matteob29/EA113_-_Conception_dun_amplificateur_audio/PCB/vue_dessous.jpg

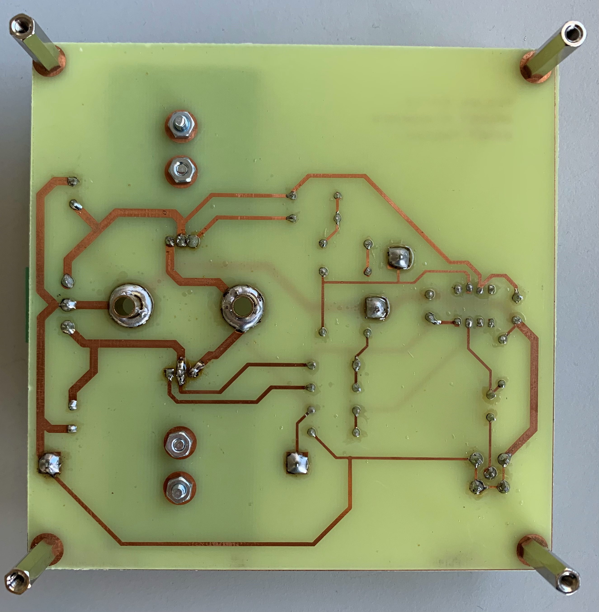
PCB/vue_dessous.jpg
