matteob29/EA113_-_Conception_dun_amplificateur_audio/PCB/vue_cote.jpg

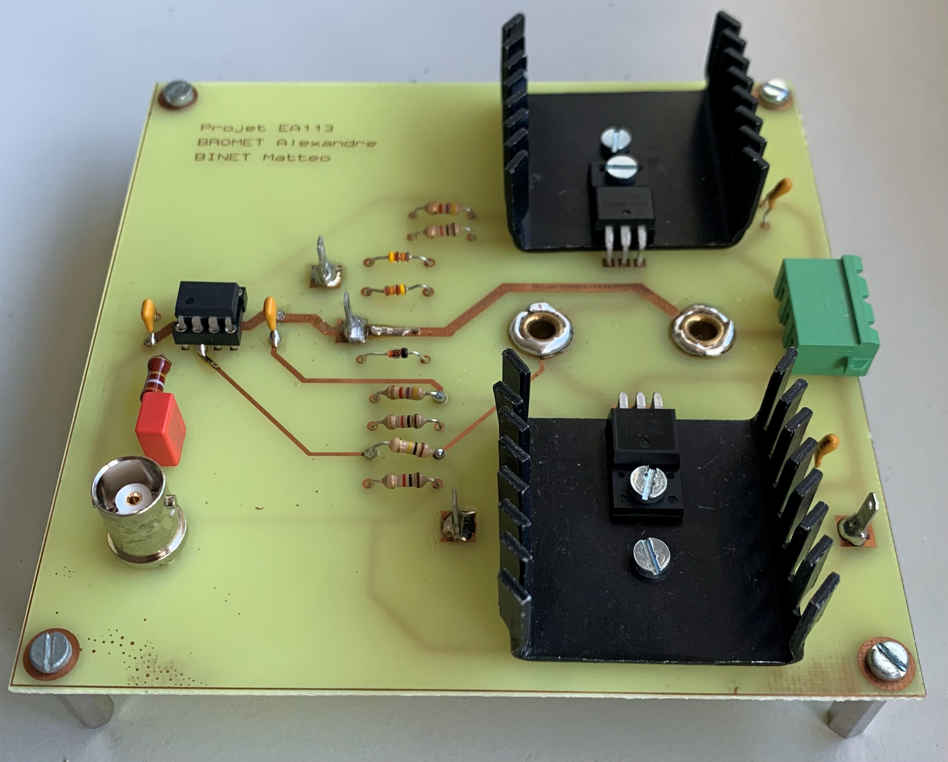
PCB/vue_cote.jpg
