matteob29/EA113_-_Conception_dun_amplificateur_audio/PCB/vue_3D_cote.pdf

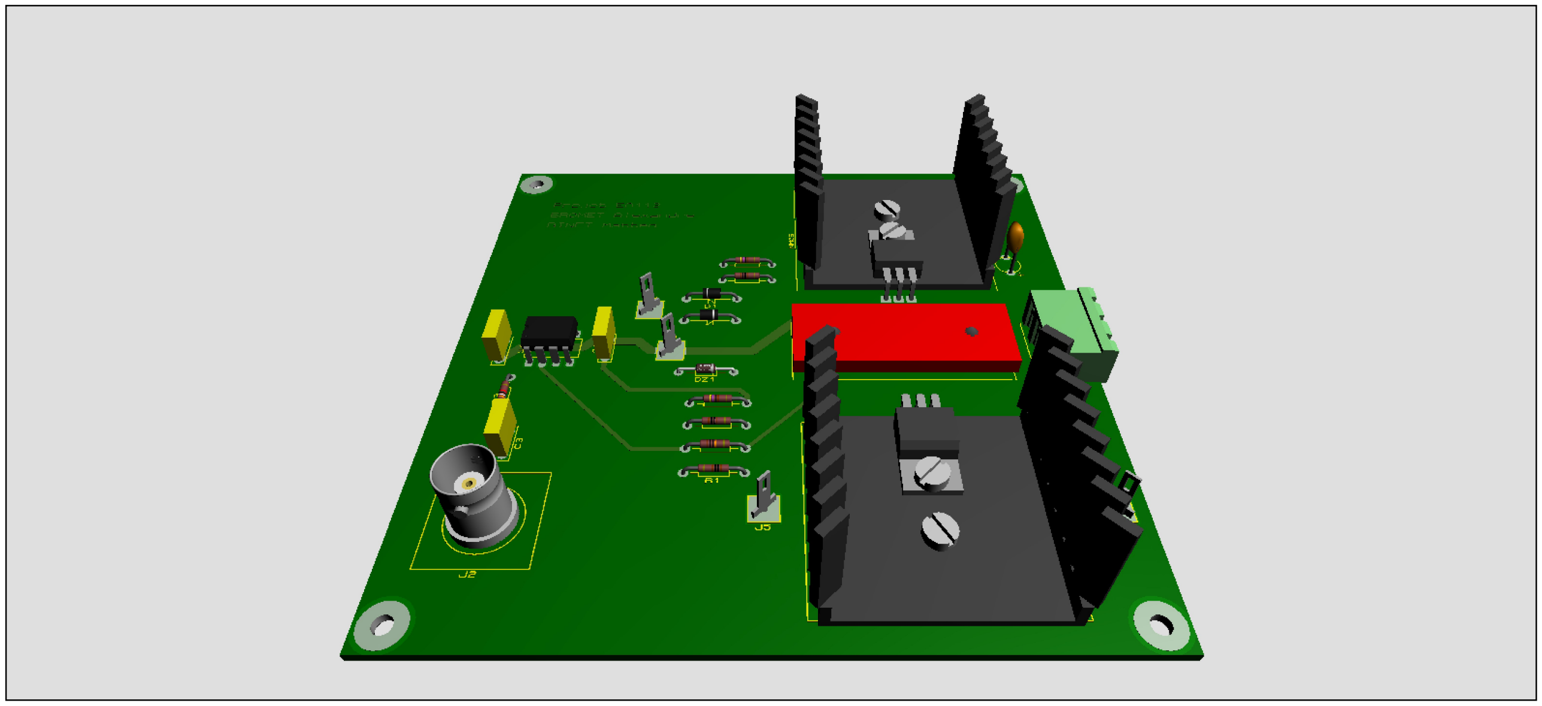
[picture p3: figure]
