matteob29/EA113_-_Conception_dun_amplificateur_audio/PCB/vue_dessus.jpg

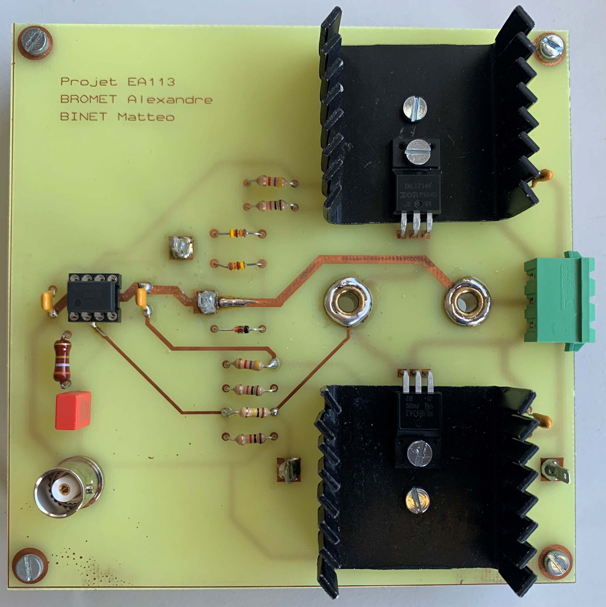
PCB/vue_dessus.jpg
