matteob29/EA113_-_Conception_dun_amplificateur_audio/Schematisation/Etage_circuit.png

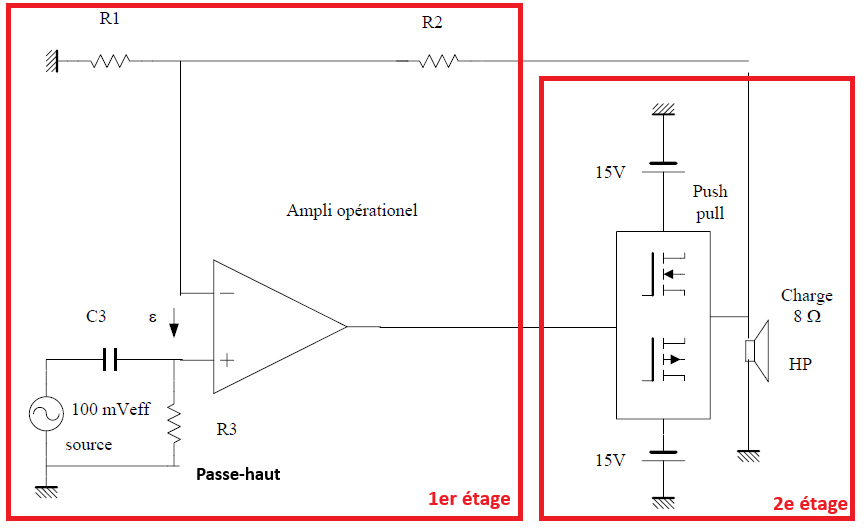
Schematisation/Etage_circuit.png
