matteob29/EA113_-_Conception_dun_amplificateur_audio/Schematisation/pushPull.png

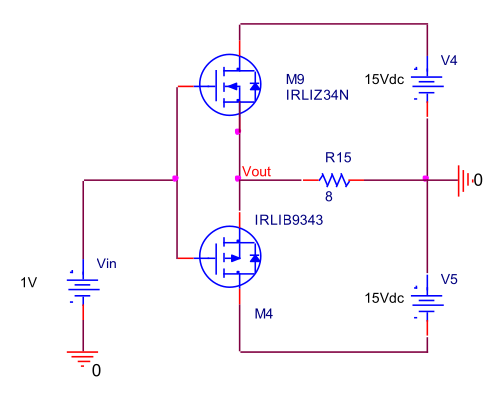
Schematisation/pushPull.png
