matteob29/EA113_-_Conception_dun_amplificateur_audio/Schematisation/pushPullAmeliore.PNG

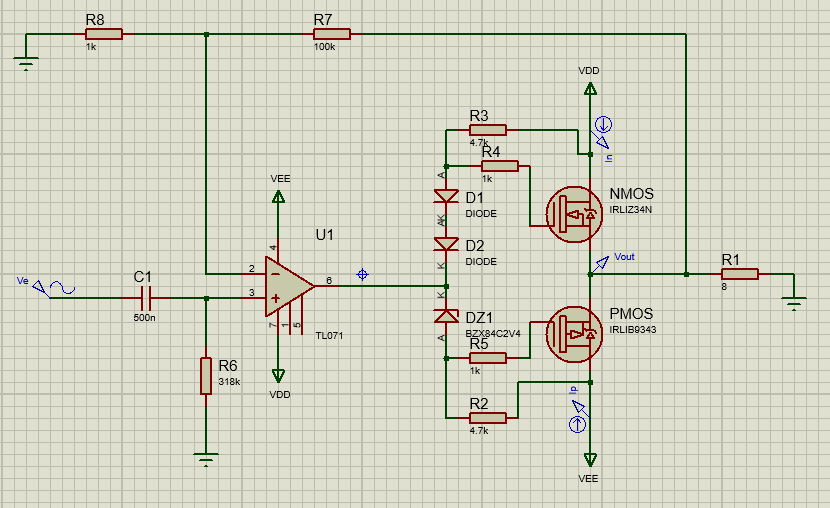
Schematisation/pushPullAmeliore.PNG
