matteob29/EA113_-_Conception_dun_amplificateur_audio/Simulations/I -/I.2.a.Id(Vgs)_gm.PNG

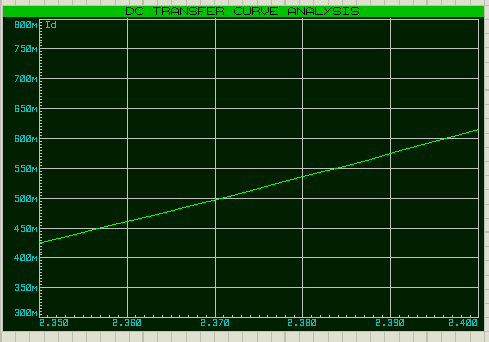
Simulations/I -/I.2.a.Id(Vgs)_gm.PNG
