matteob29/EA113_-_Conception_dun_amplificateur_audio/Simulations/I -/I.2.b.Id(Vds)_Vdss.PNG

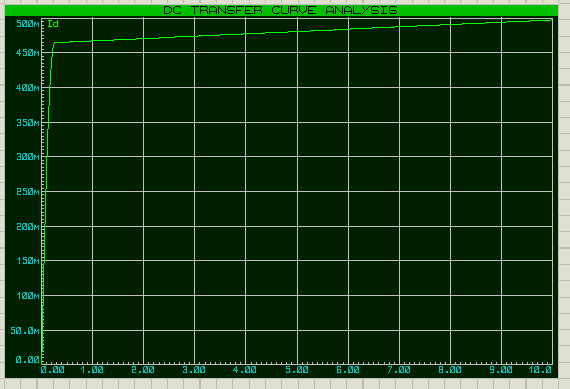
Simulations/I -/I.2.b.Id(Vds)_Vdss.PNG
