matteob29/EA113_-_Conception_dun_amplificateur_audio/Simulations/II -/II.7.Id(Vgs).PNG

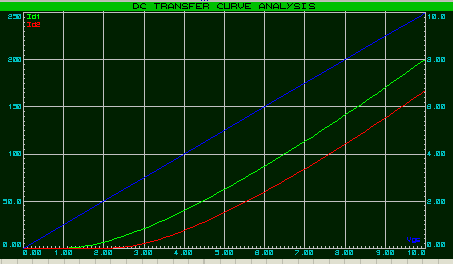
Simulations/II -/II.7.Id(Vgs).PNG
