matteob29/EA113_-_Conception_dun_amplificateur_audio/Simulations/III -/III.5.VTO=5.PNG

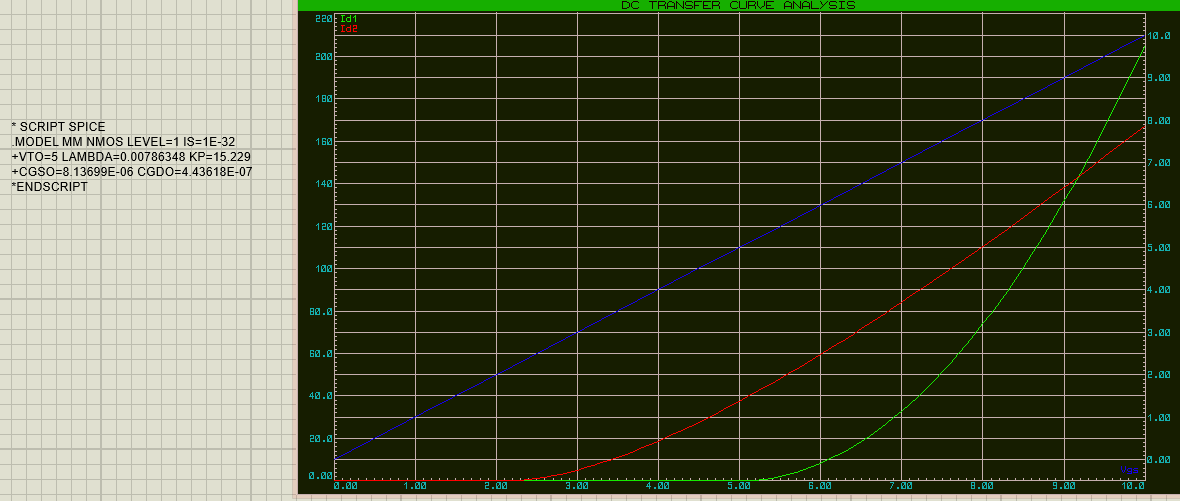
Simulations/III -/III.5.VTO=5.PNG
