matteob29/EA113_-_Conception_dun_amplificateur_audio/Simulations/IV -/IV.2.a.Vout(Vin).PNG

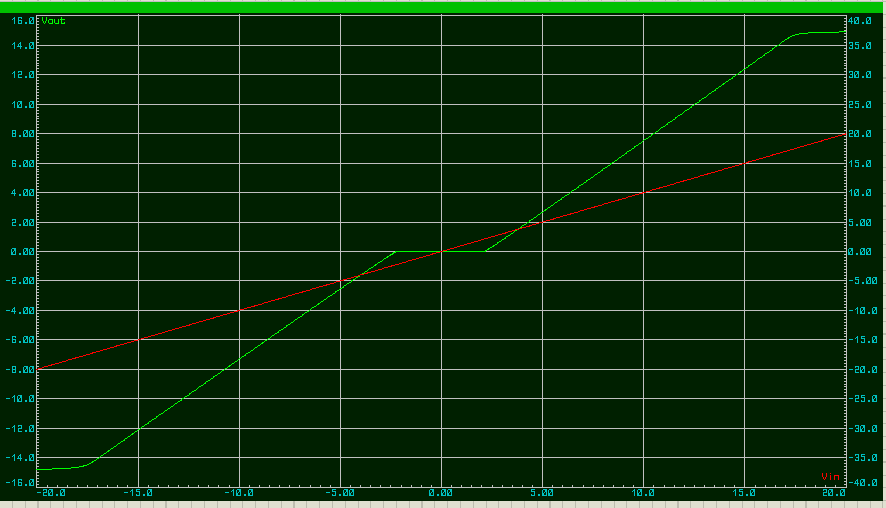
Simulations/IV -/IV.2.a.Vout(Vin).PNG
