matteob29/EA113_-_Conception_dun_amplificateur_audio/Simulations/IV -/IV.2.c.In(t).Ip(t).PNG

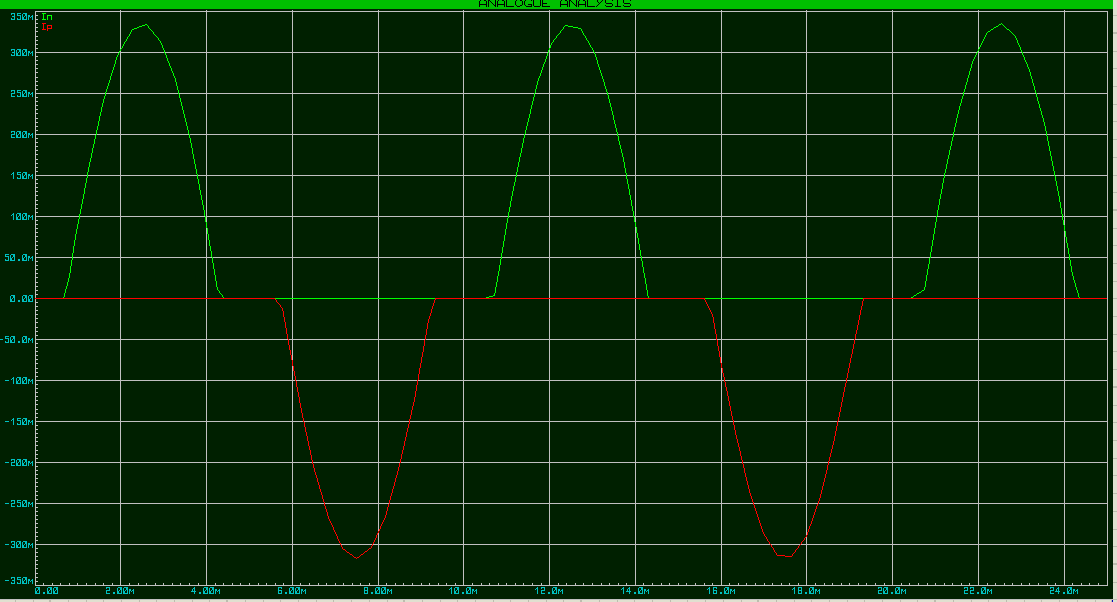
Simulations/IV -/IV.2.c.In(t).Ip(t).PNG
