matteob29/EA113_-_Conception_dun_amplificateur_audio/Simulations/V -/B.V.2.Vout(Vin).PNG

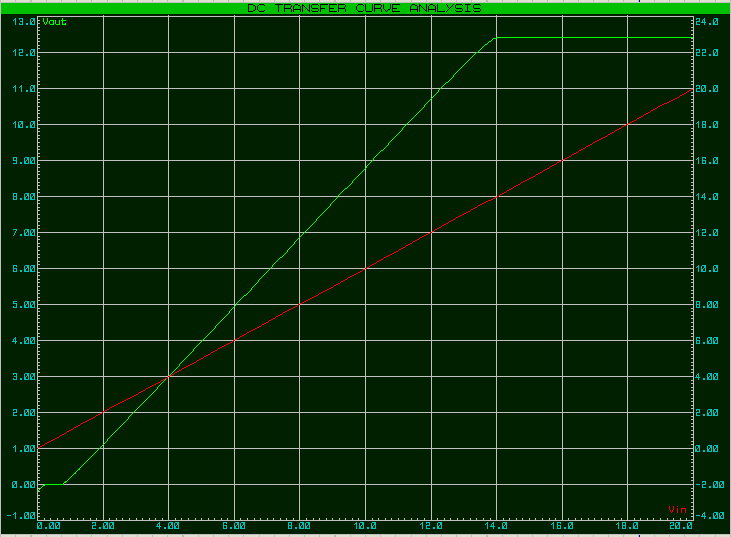
Simulations/V -/B.V.2.Vout(Vin).PNG
