matteob29/EA113_-_Conception_dun_amplificateur_audio/Simulations/V -/B.V.3.Vin_Iin.PNG

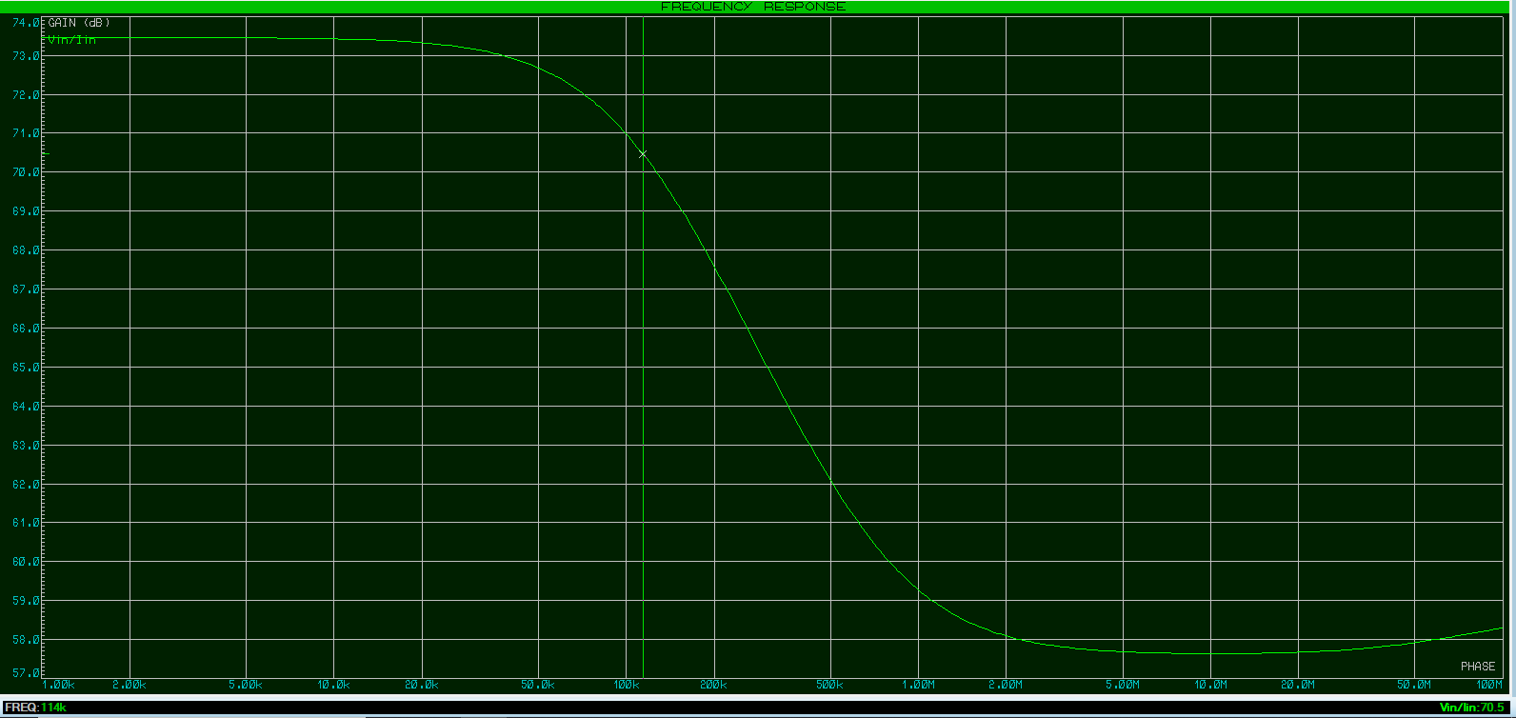
Simulations/V -/B.V.3.Vin_Iin.PNG
