matteob29/EA113_-_Conception_dun_amplificateur_audio/Simulations/VI -/B.VI.2.d.Vout(t).PNG

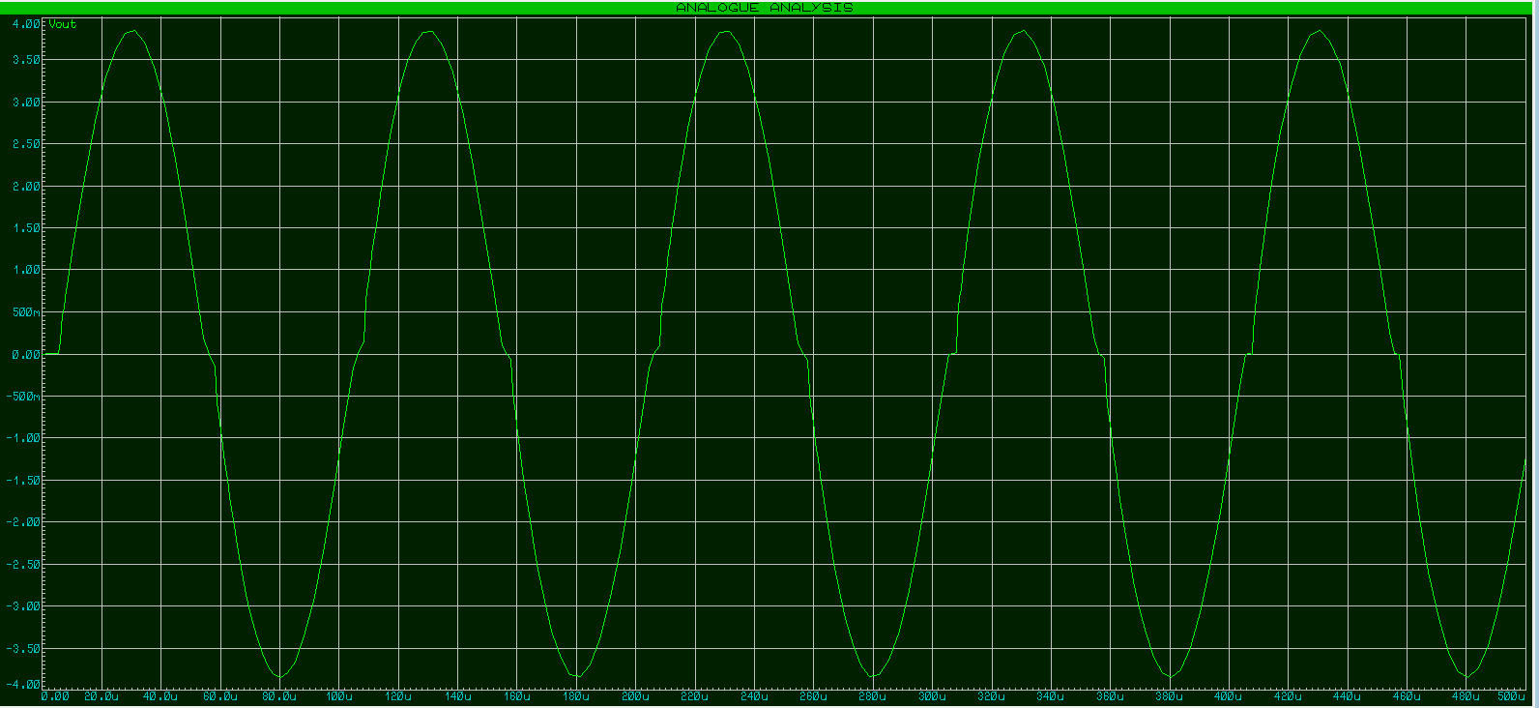
Simulations/VI -/B.VI.2.d.Vout(t).PNG
