matteob29/EA113_-_Conception_dun_amplificateur_audio/TP_ampli_PUSH_PULL/II - Amélioration de la linéarité/Ve(t) et Vs(t).PNG

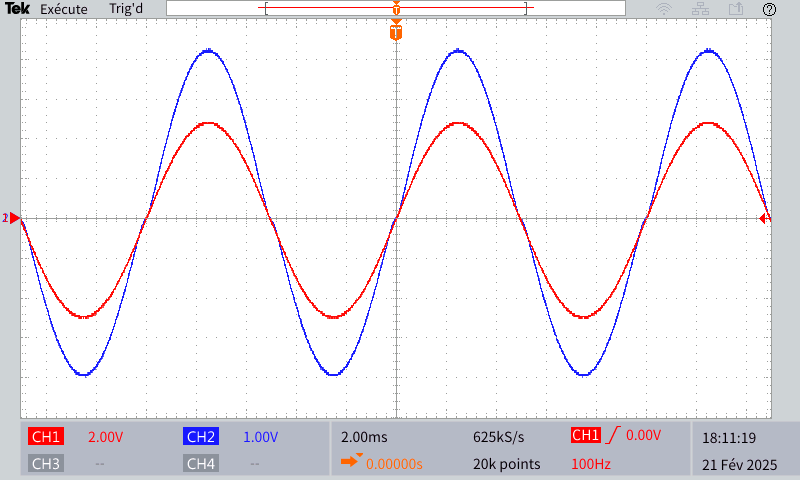
TP_ampli_PUSH_PULL/II - Amélioration de la linéarité/Ve(t) et Vs(t).PNG
