matteob29/EA113_-_Conception_dun_amplificateur_audio/TP_ampli_PUSH_PULL/II - Amélioration de la linéarité/Vs(Ve).PNG

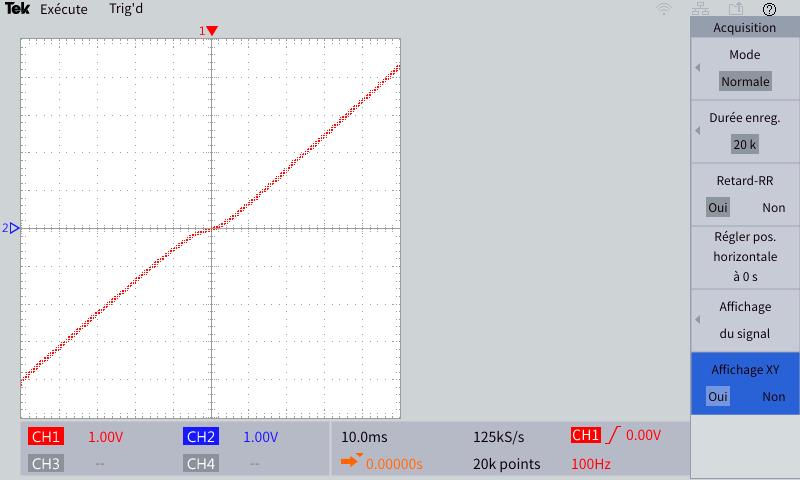
TP_ampli_PUSH_PULL/II - Amélioration de la linéarité/Vs(Ve).PNG
