matteob29/EA113_-_Conception_dun_amplificateur_audio/TP_ampli_PUSH_PULL/III - Rendement de l'amplificateur Push Pull en Classe B/Vs(t)max.PNG

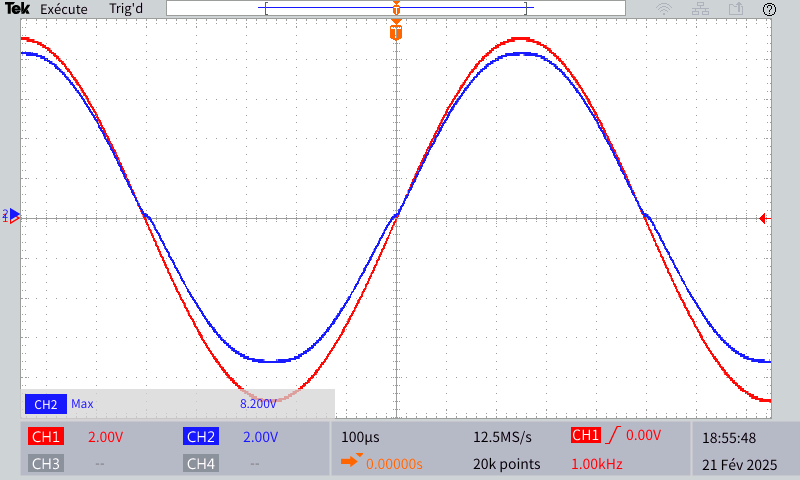
TP_ampli_PUSH_PULL/III - Rendement de l'amplificateur Push Pull en Classe B/Vs(t)max.PNG
