matteob29/EA113_-_Conception_dun_amplificateur_audio/Schematisation/pushPullAmeliore.pdf

R1

## NMOS

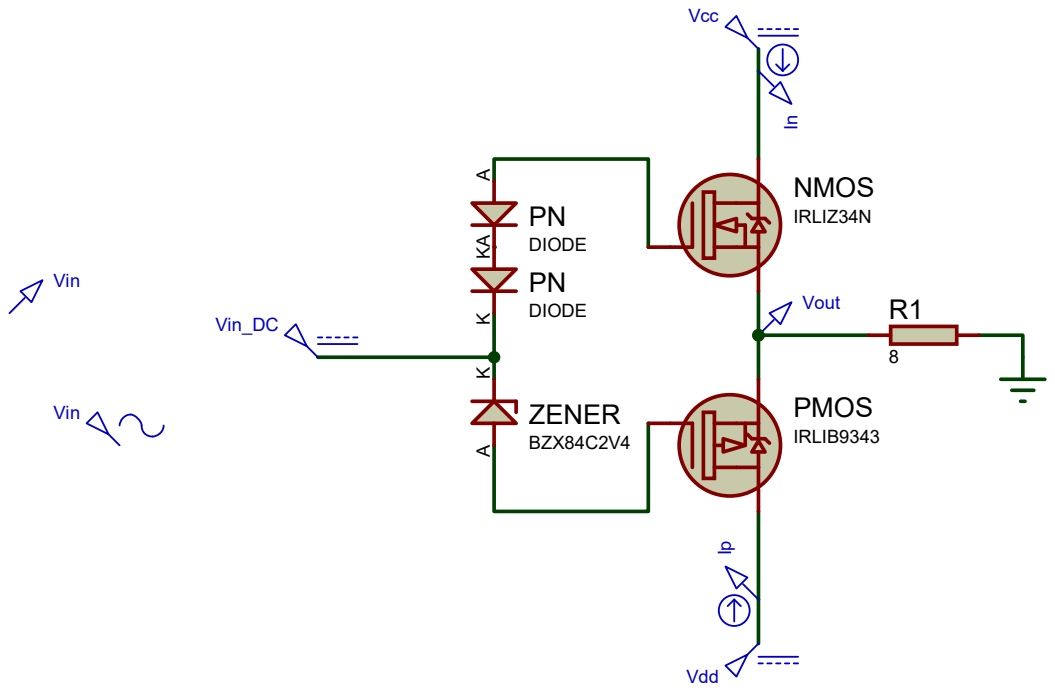
[picture p32: page 1]
IRLIZ34N; PMOS; IRLIB9343; Vout; Vcc; Vdd; Vin; DIODE A K; ZENER; BZX84C2V4 A K PN; DIODE; Vin_DC
