matteob29/EA113_-_Conception_dun_amplificateur_audio/PCB/layout_circuit.pdf

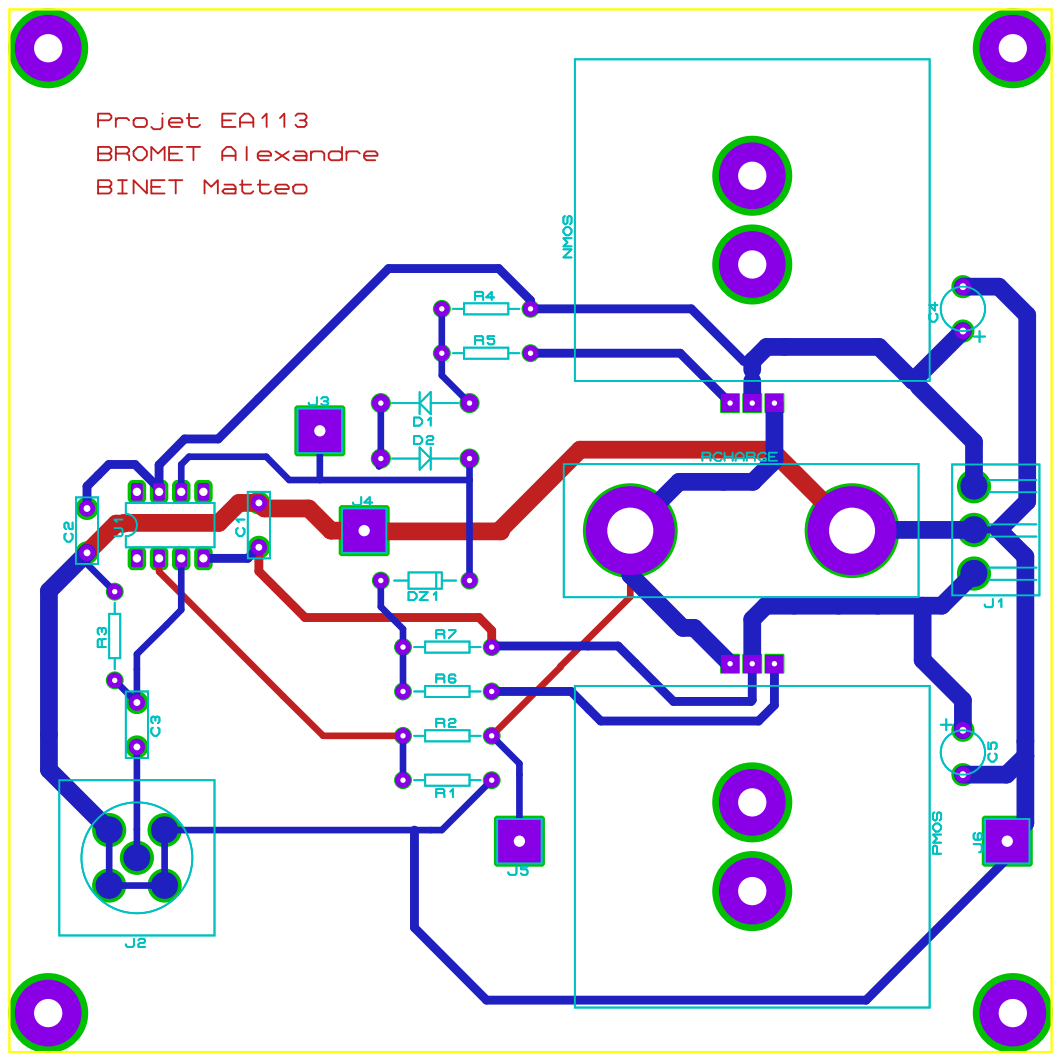
[picture p33: page 1]
