matteob29/EA113_-_Conception_dun_amplificateur_audio/PCB/Silk_top.PDF

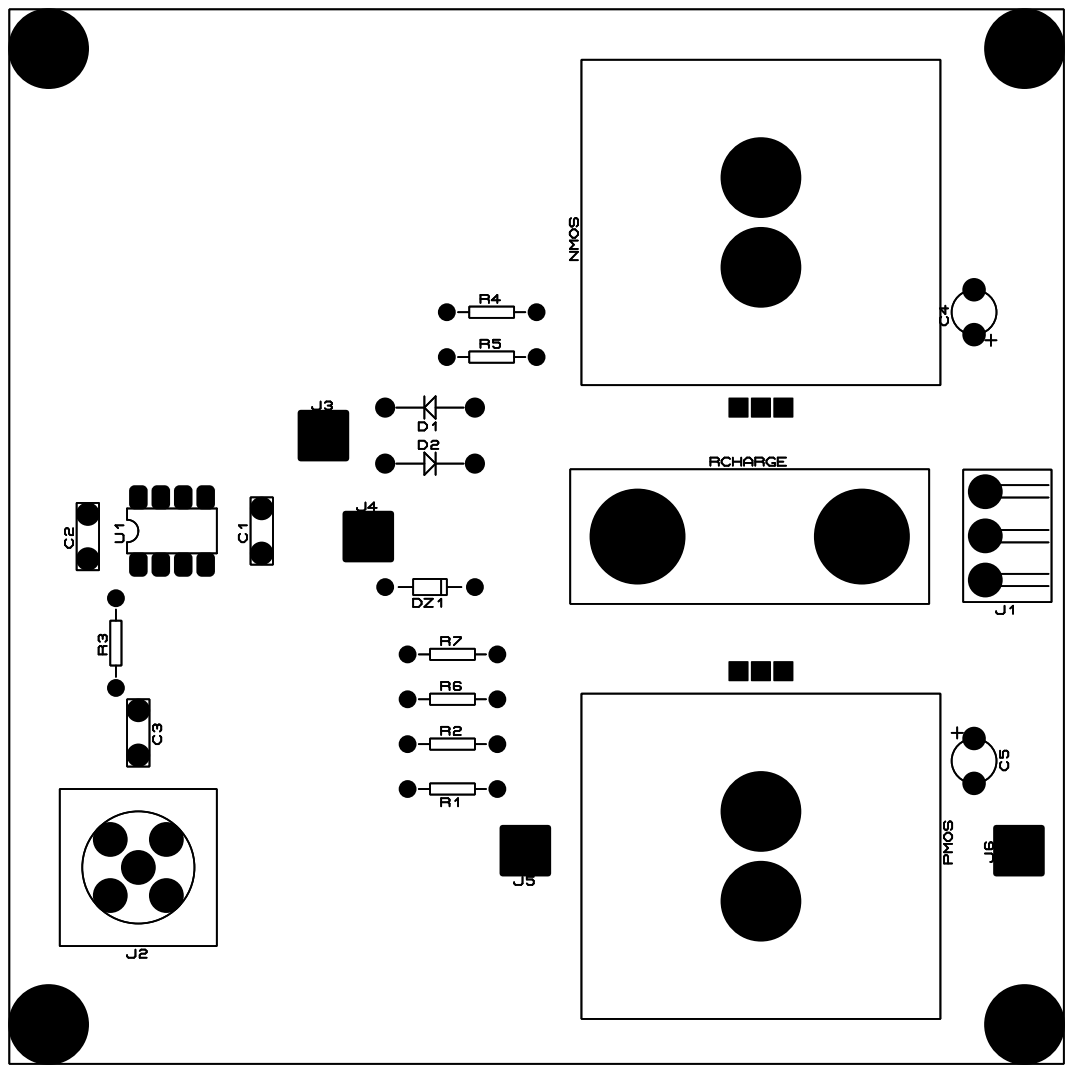
[picture p34: page 1]
