matteob29/EA113_-_Conception_dun_amplificateur_audio/PCB/Typons_bottom.PDF

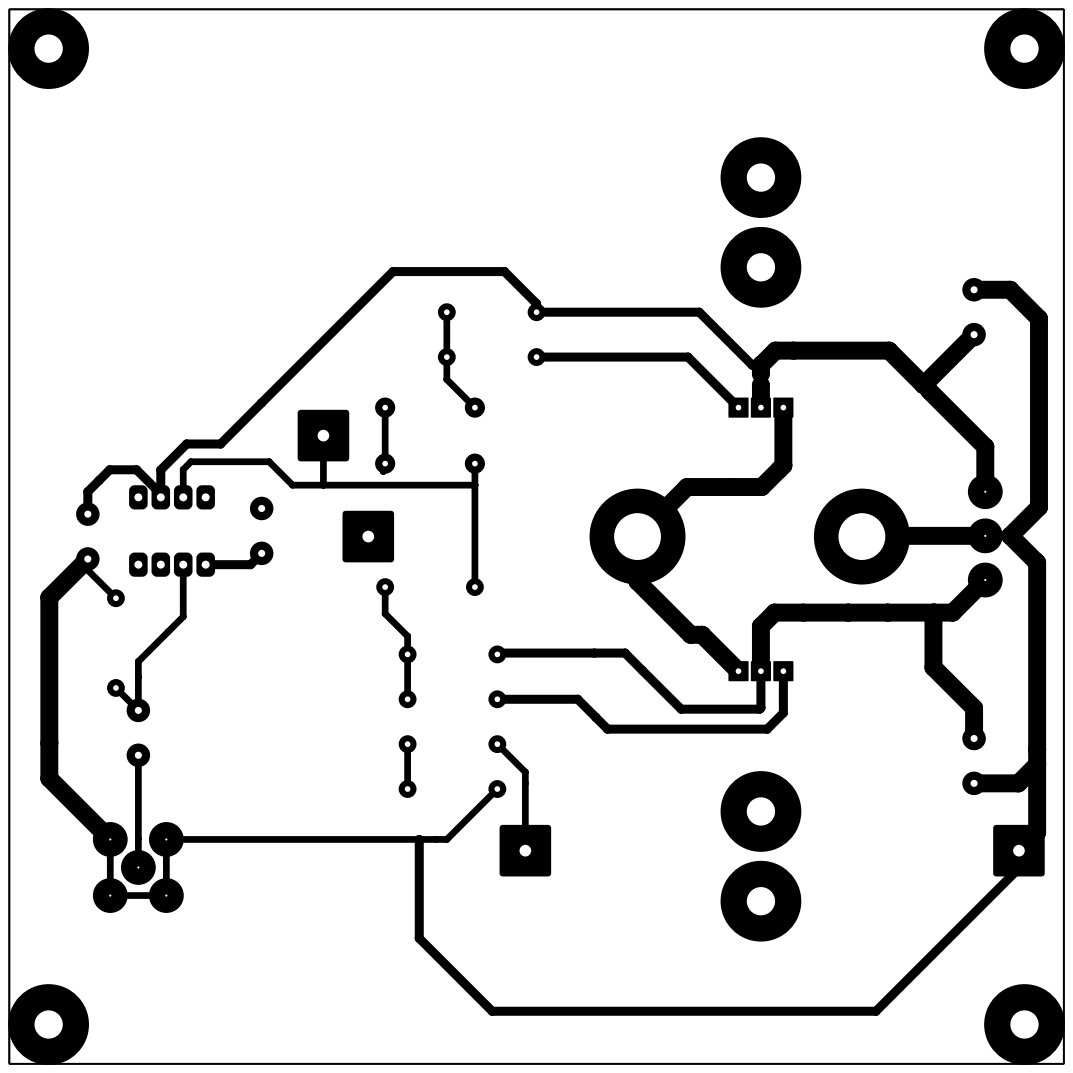
[picture p35: page 1]
