matteob29/EA113_-_Conception_dun_amplificateur_audio/PCB/Typons_top.PDF

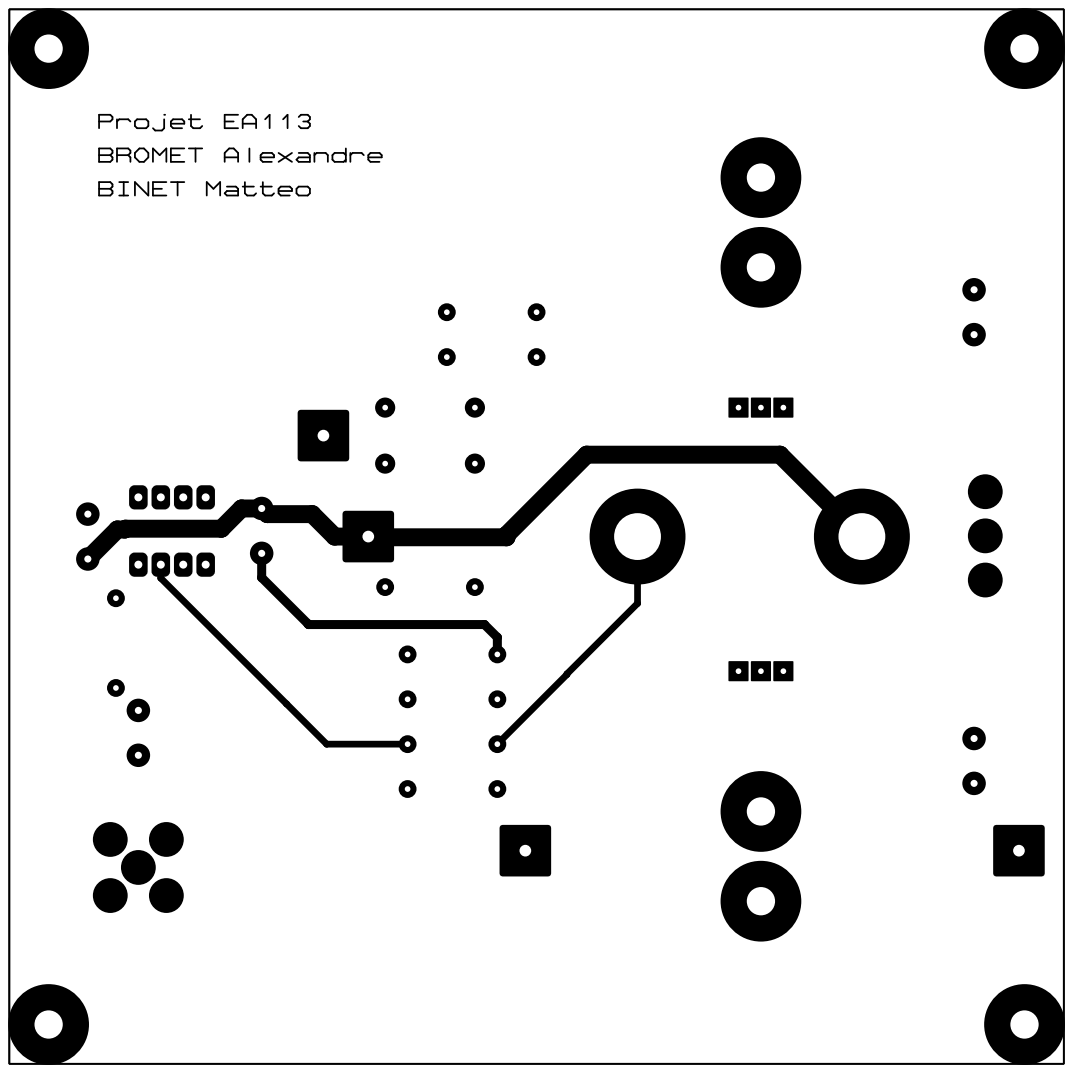
[picture p36: page 1]
