matteob29/EA113_-_Conception_dun_amplificateur_audio/Schematisation/schéma_circuit.pdf

R2

R1

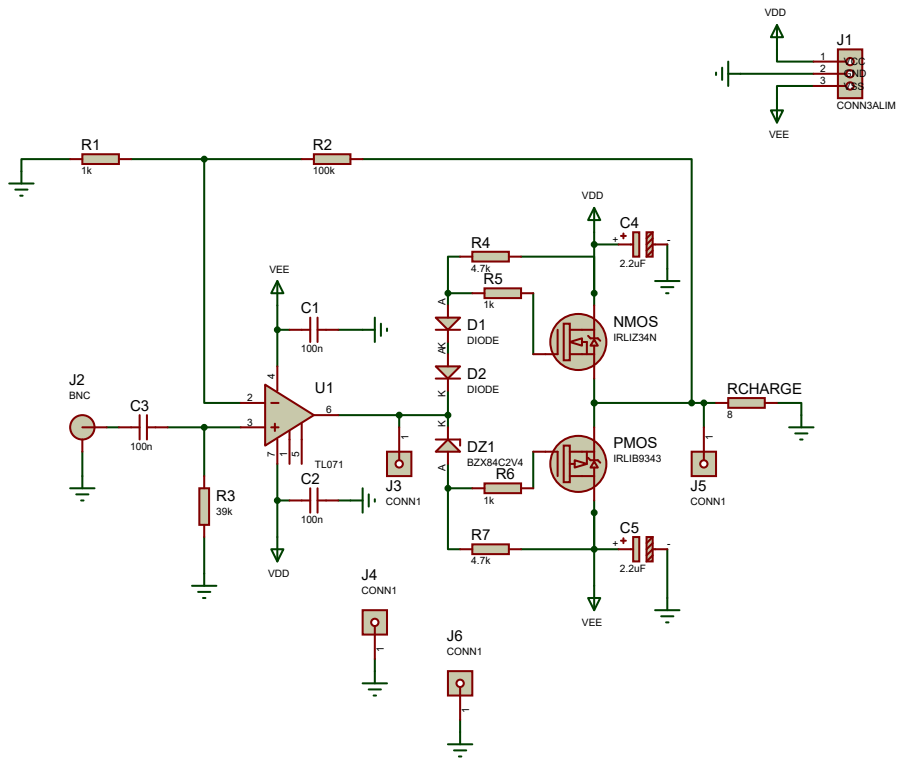
[picture p37: page 1]
