matteob29/EA113_-_Conception_dun_amplificateur_audio/(list of files, drawings)

Other design files:
Proteus/ampli_PCB.pdsprj
Proteus/Project Backups/ampli_PCB [20250314, 12-20-40].pdsprj
Proteus/Project Backups/ampli_PCB [20250314, 12-22-02].pdsprj
Proteus/Project Backups/ampli_PCB [20250314, 12-22-03].pdsprj
Proteus/Project Backups/ampli_PCB [20250314, 12-26-03].pdsprj
Proteus/Project Backups/ampli_PCB [20250314, 12-26-04].pdsprj
Proteus/Project Backups/ampli_PCB [20250314, 12-26-07].pdsprj
Proteus/Project Backups/ampli_PCB [20250314, 12-27-52].pdsprj
Proteus/Project Backups/ampli_PCB [20250416, 17-52-29].pdsprj
Proteus/Project Backups/ampli_PCB [20250416, 17-52-30].pdsprj
Proteus/Project Backups/ampli_PCB [20250416, 18-11-51].pdsprj
Proteus/Project Backups/Projet_EN134_ABMB [20250214, 10-39-44].pdsprj
Proteus/Project Backups/Projet_EN134_ABMB [20250214, 10-51-53].pdsprj
Proteus/Project Backups/Projet_EN134_ABMB [20250214, 10-51-56].pdsprj
Proteus/Project Backups/Projet_EN134_ABMB [20250214, 11-04-12].pdsprj
Proteus/Project Backups/Projet_EN134_ABMB [20250214, 11-24-08].pdsprj
Proteus/Project Backups/Projet_EN134_ABMB [20250214, 11-24-52].pdsprj
Proteus/Project Backups/Projet_EN134_ABMB [20250214, 11-26-35].pdsprj
Proteus/Project Backups/Projet_EN134_ABMB [20250214, 11-45-03].pdsprj
Proteus/Project Backups/Projet_EN134_ABMB [20250214, 11-57-49].pdsprj
Proteus/Project Backups/Projet_EN134_ABMB [20250214, 12-02-04].pdsprj
Proteus/Project Backups/Projet_EN134_ABMB partie V [20250214, 12-29-46].pdsprj
Proteus/Project Backups/Projet_EN134_ABMB partie V [20250214, 12-29-47].pdsprj
Proteus/Project Backups/Projet_EN134_ABMB partie V [20250214, 12-31-14].pdsprj
Proteus/Project Backups/Projet_EN134_ABMB partie V [20250228, 10-05-13].pdsprj
Proteus/Project Backups/Projet_EN134_ABMB partie V [20250228, 10-06-04].pdsprj
Proteus/Project Backups/Projet_EN134_ABMB partie V [20250228, 10-46-50].pdsprj
Proteus/Project Backups/Projet_EN134_ABMB partie V [20250228, 11-25-36].pdsprj
Proteus/Project Backups/Projet_EN134_ABMB partie V [20250228, 11-32-12].pdsprj
Proteus/Project Backups/Projet_EN134_ABMB partie V [20250228, 11-38-23].pdsprj
Proteus/Project Backups/Projet_EN134_ABMB partie V [20250228, 11-44-44].pdsprj
Proteus/Project Backups/Projet_EN134_ABMB partie V [20250228, 11-48-19].pdsprj
Proteus/Project Backups/Projet_EN134_ABMB partie V [20250228, 12-00-14].pdsprj
Proteus/Project Backups/Projet_EN134_ABMB partie V [20250228, 12-14-44].pdsprj
Proteus/Projet_EN134_ABMB partie V (copie).pdsprj
Proteus/Projet_EN134_ABMB partie V.pdsprj
Proteus/Projet_EN134_ABMB.pdsprj
