matteob29/EA113_-_Conception_dun_amplificateur_audio/(commit log)

2025-10-28 reste des fichiers à upload
    [Projet_EN134_ABMB [20250214, 10-39-44].pdsprj, Projet_EN134_ABMB [20250214, 10-51-53].pdsprj, Projet_EN134_ABMB [20250214, 10-51-56].pdsprj, Projet_EN134_ABMB [20250214, 11-04-12].pdsprj, Projet_EN134_ABMB [20250214, 11-24-08].pdsprj, Projet_EN134_ABMB [20250214, 11-24-52].pdsprj, Projet_EN134_ABMB [20250214, 11-26-35].pdsprj, Projet_EN134_ABMB [20250214, 11-45-03].pdsprj]
2025-10-28 fichiers triés
    [Projet_EN134_ABMB [20250214, 10-39-44].pdsprj, Projet_EN134_ABMB [20250214, 10-51-53].pdsprj, Projet_EN134_ABMB [20250214, 10-51-56].pdsprj, Projet_EN134_ABMB [20250214, 11-04-12].pdsprj, Projet_EN134_ABMB [20250214, 11-24-08].pdsprj, Projet_EN134_ABMB [20250214, 11-24-52].pdsprj, Projet_EN134_ABMB [20250214, 11-26-35].pdsprj, Projet_EN134_ABMB [20250214, 11-45-03].pdsprj]
